MakeMagazinDE/Akkuschrauberbike/README.md

GitHub Logo

Maker Media GmbH

***

# Akkuschrauberbike

### Von der Idee bis zum Praxistest – ein Vater-Sohn-Bastelprojekt

Geht das wirklich – ein E-Bike selbst bauen? Noch dazu mit einem zweckentfremdeten Akkuschrauber als Antrieb? Aber ja! Der erste Prototyp von Christian und Finn Koubek fuhr schon nach einem Werkstatt-Wochenende. Doch danach ging die Feinarbeit los. Heraus kam ein tourentaugliches E-Bike mit Daumengas, Arduino-Steuerung, Cockpit-Anzeige, Ersatzakku und nicht zuletztmaßgeschneiderten Packtaschen, die die Technik wetterfest verstecken.

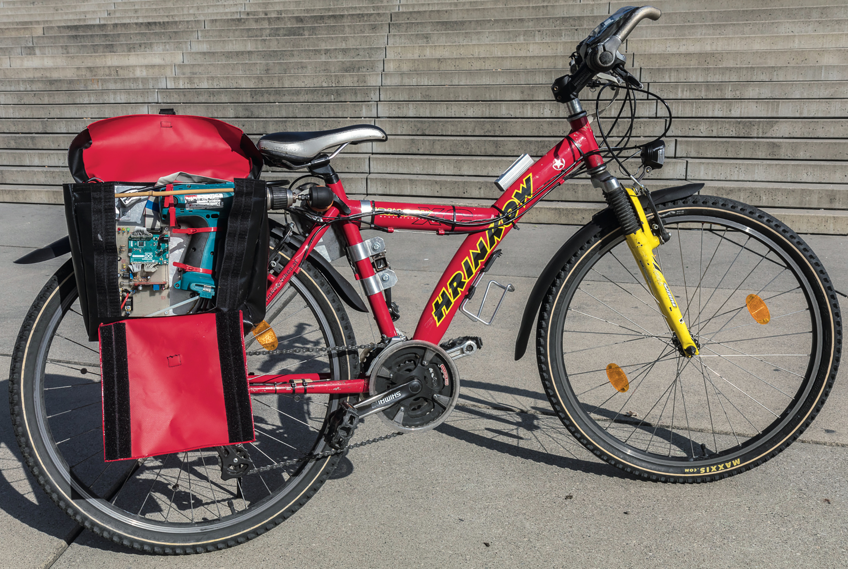
[picture p1: Bike.JPG]


Hier gibt es die Schaltpläne sowie den Arduino-Code zum Download. Die beiden vollständigen Artikel zum Projekt gibt es in der **[Make-Ausgabe 1/20 ab Seite 80](https://www.heise.de/select/make/2020/1/1582901384120081)** und ab 16. April 2020 in der **[Make-Ausgabe 2/20 ab Seite 82](https://www.heise.de/select/make/2020/2/1587492321267806)** zu lesen.

### Hinweis zur rechtlichen Lage

Die Autoren des Artikels leben in Österreich, deshalb beziehen sich Aussagen über die Gesetzeslage im Text nur auf dieses Land. In Österreich wird nicht unterschieden zwischen Pedelecs, deren Motor lediglich das Treten in die Pedale unterstützt, und E-Bikes, bei denen man ohne Treten Gas geben kann – sofern die Leistung und Geschwindigkeit unter bestimmten Werten bleibt, gelten beide gleichermaßen als Fahrräder.

Nicht so in Deutschland: Sofern die ohne eigenes Treten erreichte Geschwindigkeit über 6km/h liegt, handelt es sich laut §1, Absatz 3 des Straßenverkehrsgesetzes (STVG) um ein Kraftfahrzeug, das somit zugelassen werden muss und dafür eine Betriebserlaubnis, Einzelgenehmigung oder EG-Typgenehmigung braucht, von der Führerschein-, Versicherungs- und Helmpflicht sowie der Altersgrenze ganz zu schweigen, sofern man damit auf öffentlichen Straßen und Radwegen fahren will.
