MakeMagazinDE/Akkuschrauberbike/circuit/Cockpit-Anzeige.jpg

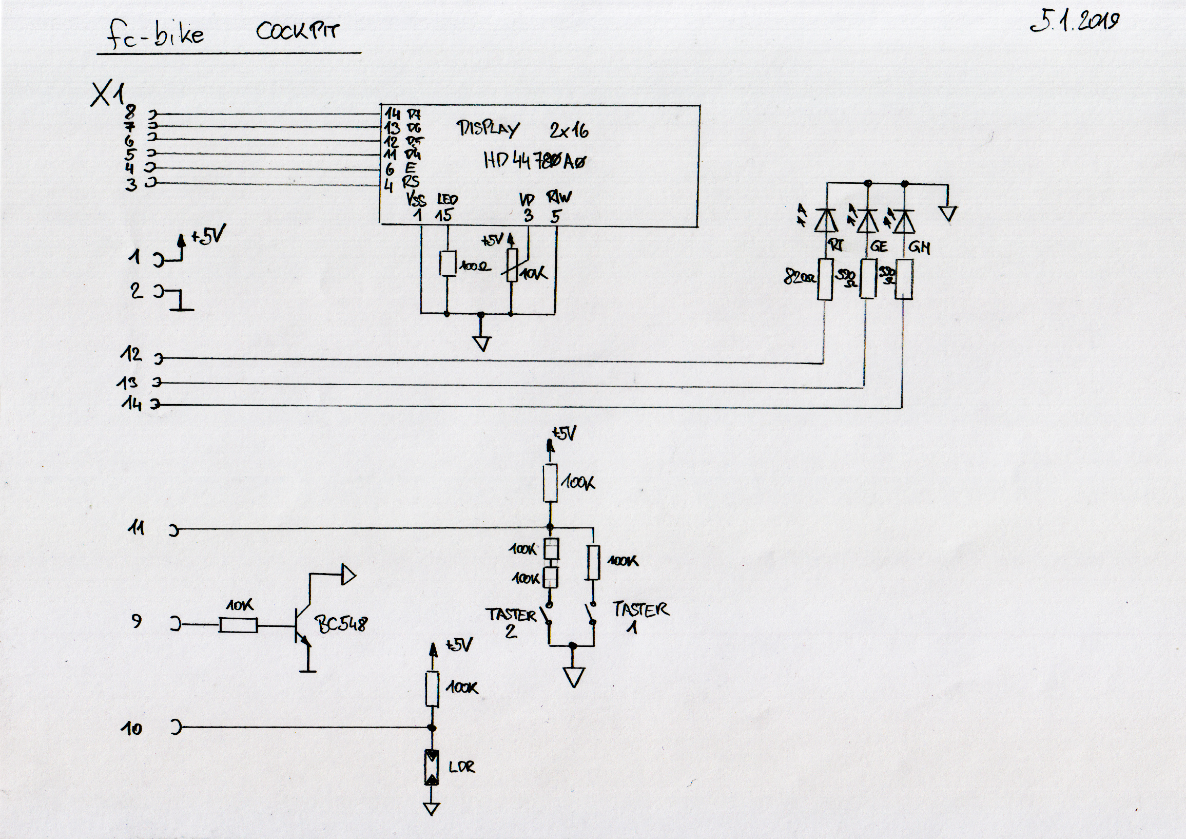
circuit/Cockpit-Anzeige.jpg
