MakeMagazinDE/Akkuschrauberbike/circuit/Hauptplatine.jpg

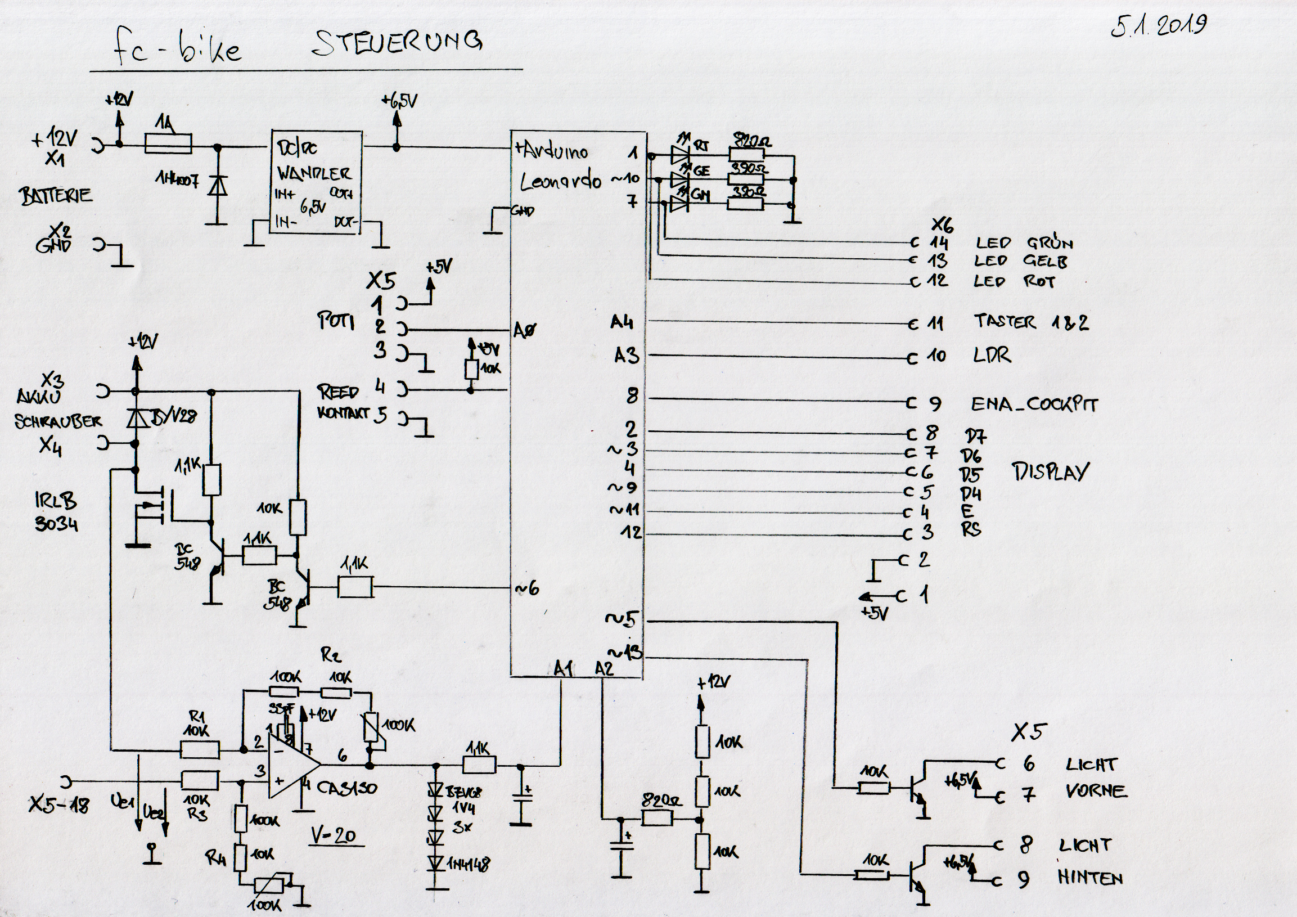
circuit/Hauptplatine.jpg
