MakeMagazinDE/Akkuschrauberbike/circuit/Übersicht.jpg

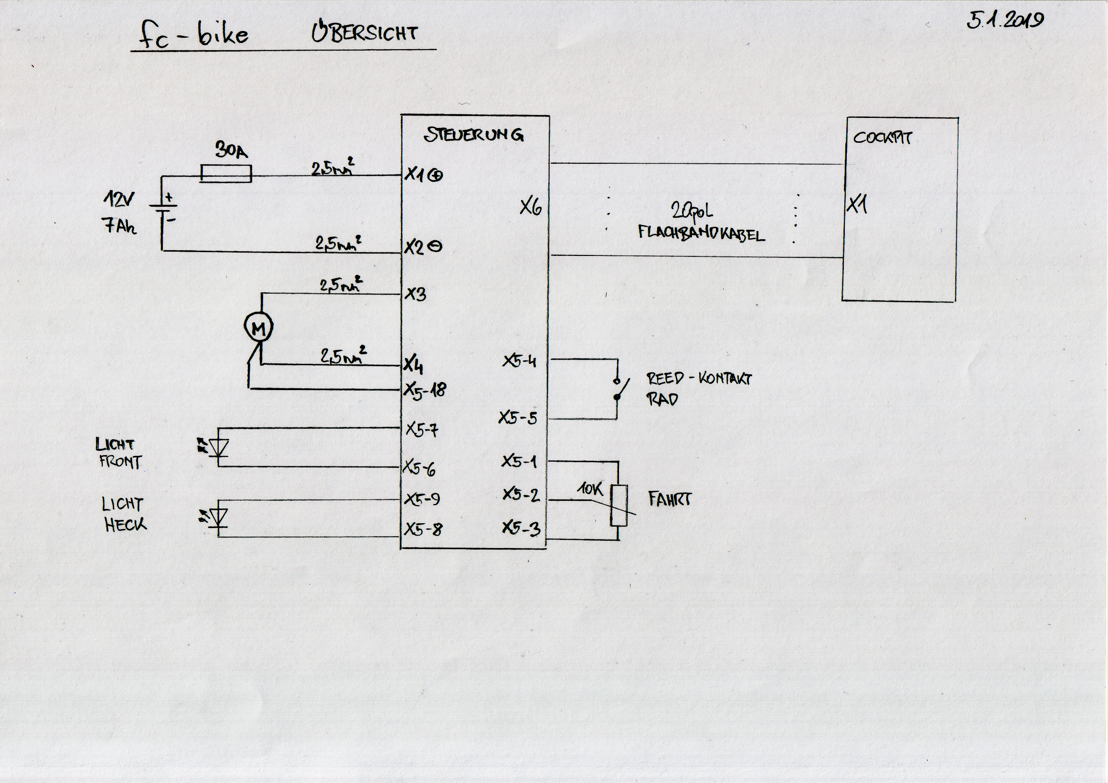
circuit/Übersicht.jpg
